LiHaoze-Bob/LingxiGlove/doc/灵犀手套_KickOff_会议.pptx

灵犀手套 LingxiGlove

双节点手语翻译系统 KickOff

2026 全国大学生物联网设计竞赛 · Espressif 赛道

Lingxi Team · 2026-05-23

## Slide 2

问题陈述

2,780 万

中国听障群体人数

5,500+

中文手语词汇量

<5%

手语翻译覆盖率估算

听障群体与健听人之间存在巨大的沟通鸿沟。现有商用手语翻译方案价格高昂（¥5,000 ~ ¥80,000），难以普及。需要一种低成本、高可用的实时手语→自然语音翻译方案。

目标：单手套 BOM ≈ ¥250，实现两个数量级降本，让手语翻译真正触手可及

## Slide 3

价值主张

社会价值

为 2780 万听障群体打通"手语→自然语音"的实时沟通通道。面向就医、求助、日常交流等高频场景，降低沟通门槛。

技术价值

ESP32-S3 + ESP-NOW 实现双手毫秒级时空同步。端侧规则识别→1D-CNN→云端 LLM 形成三级响应架构，渐进式 AI 升级。

成本优势

单手套 BOM ≈ ¥250，商用方案 ¥5k~¥80k。两个数量级降本，"极客普惠"叙事。契合 Espressif 赛道技术要求。

## Slide 4

系统五层架构

应用主控 · GestureApp / FingerSpelling / 采集模式 · LingxiGlove_Main.ino

L5

AI 与端云 · gesture_recognizer ← motion_detector · llm_client → tts_player → I2S · local_tts_fallback

L4

双手协同 · esp_now_sync (HandFrame 30B, MASTER ↔ SLAVE) · nvs_config (运行时角色/凭证)

L3

L2

传感器与执行器 · sensor_manager (MPU6050 + Flex ADC) · calibration · tts_player (I2S + MAX98357A)

L1

HAL · Arduino + FreeRTOS + ESP-IDF

Master (右手)

MPU6050 + Flex + MAX98357A

识别 / LLM / TTS / 播放

Slave (左手)

MPU6050

传感器帧上报

ESP-NOW

## Slide 5

硬件平台

Arduino Nano ESP32-S3 x2

8MB Flash + 512KB SRAM + OPI PSRAM。240MHz 双核，WiFi + BLE。

MPU6050 惯性传感器 x2

6 轴 IMU（加速度 + 陀螺仪）。I2C，50ms 采样。双手各 1 个。

弯曲传感器 x1（拇指）

单路模块，AO 接 ADC。区分握拳/张开两态。后续扩至 5 路。

MAX98357A I2S DAC

I2S 音频输出，BCLK/LRC/DIN 接 D4/D5/D6。驱动喇叭语音播报。

ESP-NOW 双板通信

链路层直连，HandFrame 30B 帧。毫秒级延迟，信道随 AP 同步。

NVS 运行时角色切换

单一固件，串口 role master/slave 切换。NVS 持久化，无需重编译。

约束：RST 不插扩展板（否则 USB 消失）；Flex 避开 A4/A5（I2C）；仅 2.4GHz WiFi

## Slide 6

软件流水线

sensor_manager

→

motion detector

→

calibration

→

gesture recognizer

→

arbitrator

→

llm client

→

tts player

→

I2S

15 个核心 C++ 模块

sensor_manager

http_client

llm_client

motion_detector

tts_player

calibration

local_tts_fallback

gesture_recognizer

offline_voice_pcm

gesture_arbitrator

accuracy_test

secrets

esp_now_sync

nvs_config

wifi_manager

15

核心 .cpp 模块

8

Host 单测套件

30B

HandFrame 协议帧

<10ms

每帧处理延迟

## Slide 7

关键技术创新

ESP-NOW 毫秒级硬同步

链路层协议绕过 WiFi 栈。HandFrame 30B 含 proto_version，信道随 AP 同步。解决双手时空对齐核心难题。

GestureArbitrator 统一决策

双手优先抑制单手（解决竞态），200ms 确认窗口 + 2s 冷却。模型无关，GestureCandidate 即接入。

Qwen-TTS + LittleFS 缓存

阿里 Qwen-TTS 非流式 WAV。FNV-1a 哈希缓存 LittleFS，命中零网络延迟。PSRAM + I2S DMA。

断网离线 PCM 兜底

local_tts_fallback 按 label 匹配离线 PCM。空表降级蜂鸣。"断网也能说救命"。

## Slide 8

AI 三级渐进架构

MVP-v1.1

端侧规则识别

RuleBased + BimanualRule

pitch/roll 阈值 + 500ms 防抖

Qwen-LLM 改写 + Qwen-TTS

V1.0

Edge Impulse 1D-CNN

双流模型（左右手各一流）

10 类 F1 >= 0.85

板上推理 < 50ms

V2.0

云端 Sign-Transformer

端侧分级触发

扩大词表至开放词汇

端云协同降级链路

当前

P3 进行中

P5-P6 规划中

核心设计：GestureRecognizer 抽象基类，MVP→ML 切换零改动主循环

## Slide 9

演示词汇清单（10 手势）

单手词汇（右手 Master）

你好

双手协同词汇（ESP-NOW）

加油

1

pitch up

6

双手同步上下

谢谢

2

pitch down

一起

7

双手同向推出

再见

3

roll 摆动

帮助

8

右手拳+左手托

明白了

我爱你

不

4

竖拇指

我们走

9

双手交叉胸口

5

握拳+拇指弯

10

代码待实现

全部词汇仅用 MPU6050 姿态角 + 拇指弯曲传感器，不依赖声学测距。任何人经短暂练习即可完成演示。

## Slide 10

当前进展

✓

P0 单手 MVP 完成

规则识别 + Qwen-TTS 闭环

✓

P1 ESP-NOW 双板通信

2026-05-14 完成，NVS 角色切换

✓

C 阶段风险全部缓解

motion_detector / calibration / local_tts_fallback

✓

手势仲裁层 (Solution C)

双手优先 + 确认窗口 + 冷却机制

8 个 Host 单测套件

全部通过，-Werror -Wpedantic

P2 弯曲传感器接入

拇指 1 路 Flex ADC，当前最高优先级

✓

!

15

核心模块

8

单测套件

10

演示手势

2

关键风险已缓解

## Slide 11

项目路线图

单手 MVP

P0

规则 + Qwen-TTS 闭环

已完成

Slave 固件 + ESP-NOW

P1

双板通信 + NVS 角色切换

已完成 05-14

弯曲传感器接入

P2

拇指 Flex ADC + 校准

进行中

Edge Impulse 1D-CNN

待开始

声学 TDOA 测距

P3

10 类 F1>=0.85

P4

Python 仿真完成

暂缓

云端 Sign-Transformer

P5

扩大词表

规划中

端云协同 + 降级联调

P6

断网播核心词

规划中

联调 + 答辩

P7

演示视频+现场对话

规划中

## Slide 12

风险分析与缓解

10 词表达力不足

中文手语 5500+ 词，10 手势覆盖有限

指拼模式兜底

动态手势分割 — 已缓解

连续手势粘连 — motion_detector 静止门控已实现

已缓解

跨用户识别率漂移

不同用户手势差异大

calibration 校准

断网哑火 — 已缓解

云端不可达 — local_tts_fallback + offline_voice_pcm

已缓解

弯曲传感器仅单路

只能区分握拳/张开两态

后续扩至 5 路

ESP-NOW 信道漂移

双手丢帧风险

强制同 AP 同步

## Slide 13

测试策略

现场准确率统计 (accuracy_test)

Host Unit Tests: C++11, make 即跑, -Werror -Wpedantic, 8 个套件

HOST 单测套件（全部通过）

Hardware-in-the-Loop: test_speaker / test_acoustic_tdoa

test_motion_detector (16)

test_calibration_core (24)

test_local_tts_fallback (20)

test_esp_now_sync (24)

test_bimanual_recognizer (8)

test_arbitrator (24)

test_llm_rewrite

accuracy_test 现场评测

混淆矩阵 + LittleFS CSV 日志。test 命令族支持按手势 ID 批量测试、导出、清除。

test_tts_parsers

CI 友好

纯 C++11，无 Arduino 依赖。每个测试目录自带 mock，make 直接编译运行。

## Slide 14

下一步计划

1

P2 弯曲传感器接入

拇指 1 路 Flex ADC 接线 + 校准 + 手势规则更新。验证 ADC 差值 > 200 count。

当前最高优先级

P3 双手数据采集 + Edge Impulse 1D-CNN

每词汇 50+ 组样本，训练轻量 1D-CNN 模型，导出 Arduino 库替换 RuleBasedRecognizer。

2

P2 完成后启动

竞赛答辩准备

录制演示视频、完善 PPT、现场对话演示。确保"我们走"代码实现 + 离线 PCM 填充。

3

P3 完成后启动

## Slide 15

Q & A

Thank You

灵犀手套 — 让手语被听见

Lingxi Team · 2026-05-23
