LiHaoze-Bob/LingxiGlove/doc/images/图1_系统五层架构图_v2.png

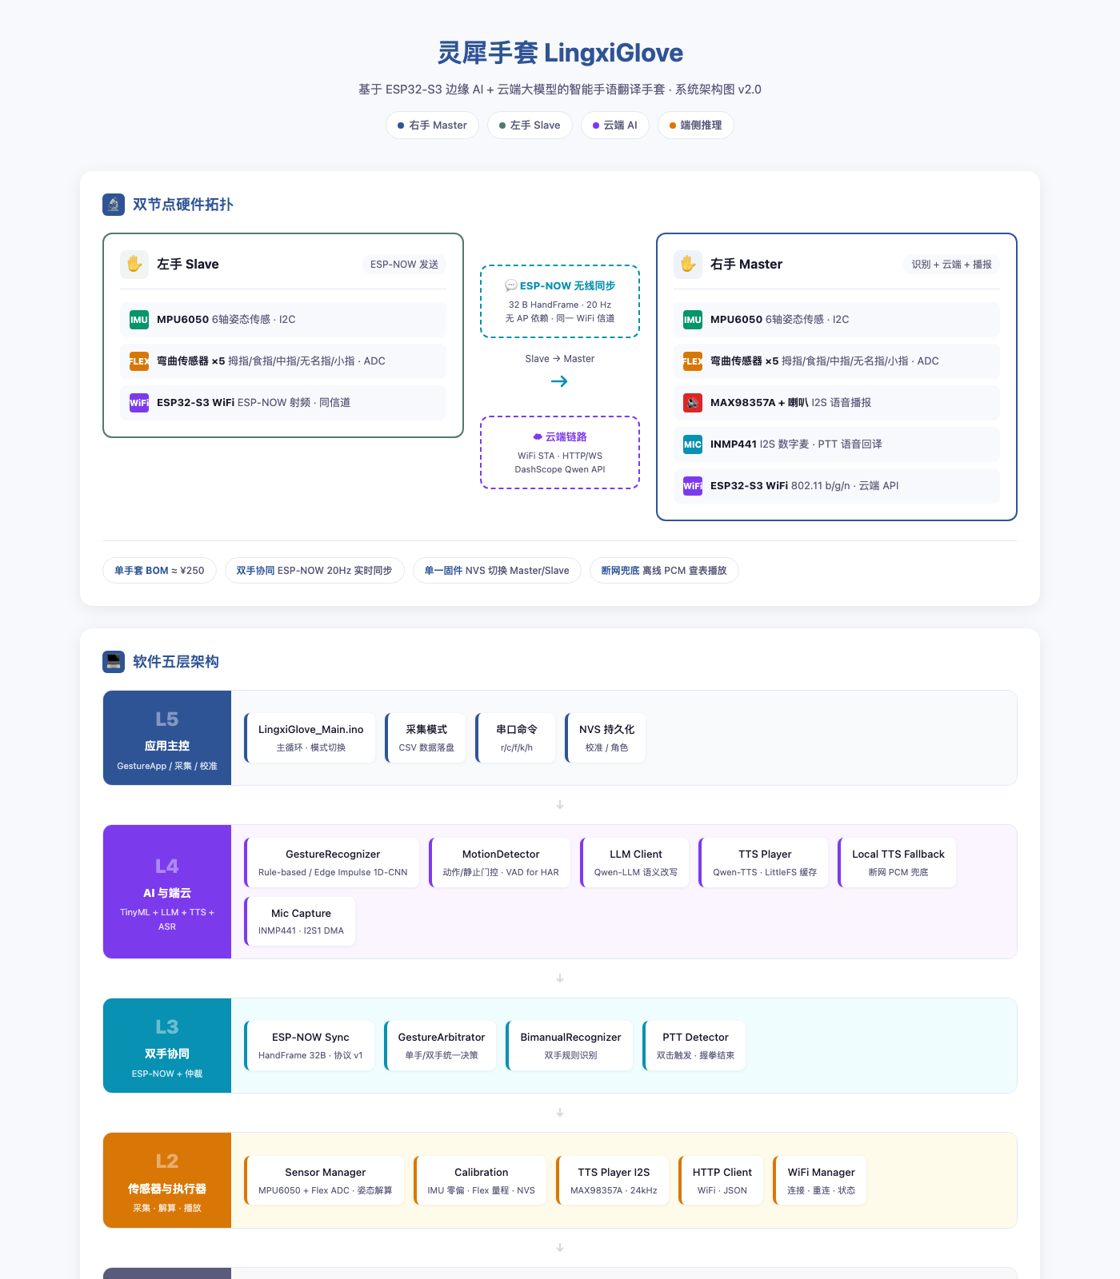
doc/images/图1_系统五层架构图_v2.png
