LiHaoze-Bob/LingxiGlove/doc/images/图2_双向交流数据流图_v2.png

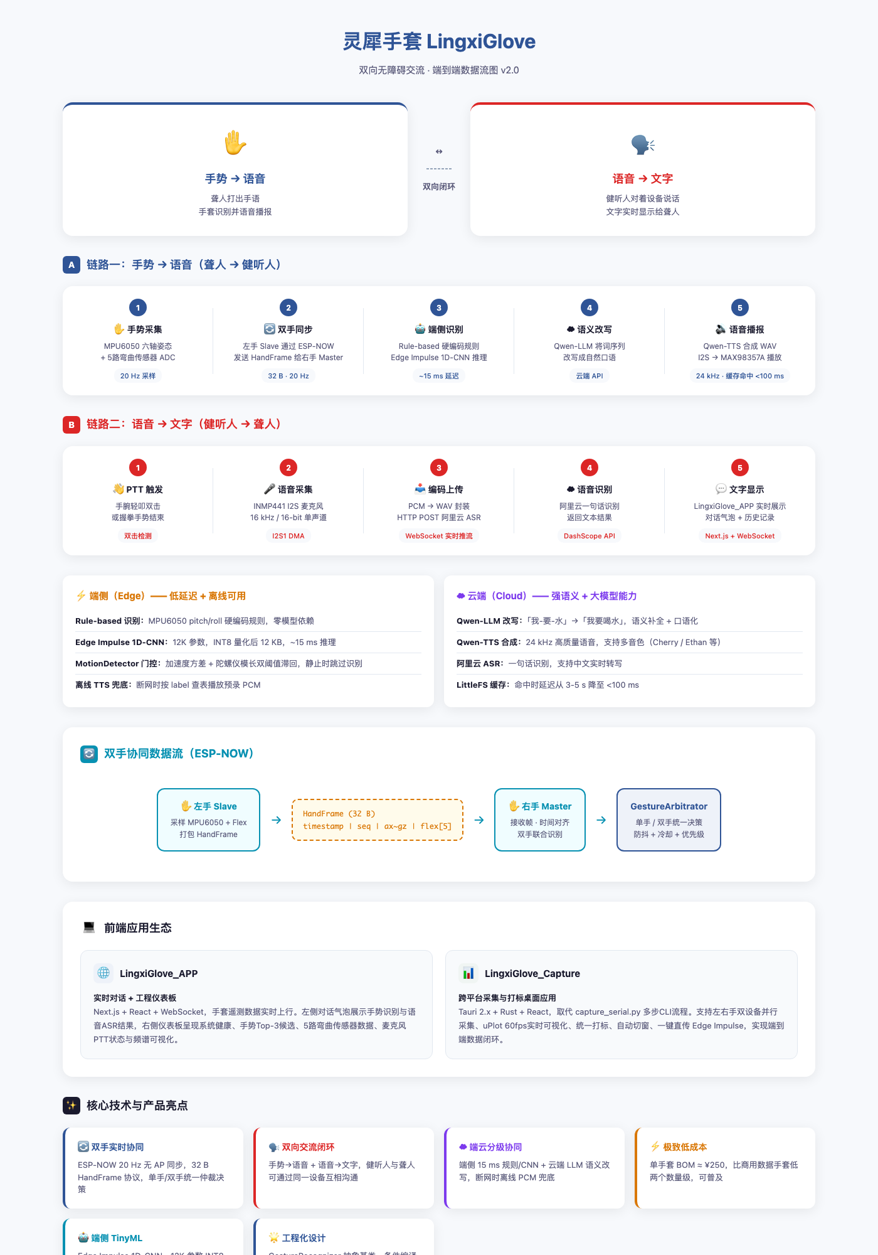
doc/images/图2_双向交流数据流图_v2.png
