LiHaoze-Bob/LingxiGlove/doc/images/图2_软件任务调度与数据流图.png

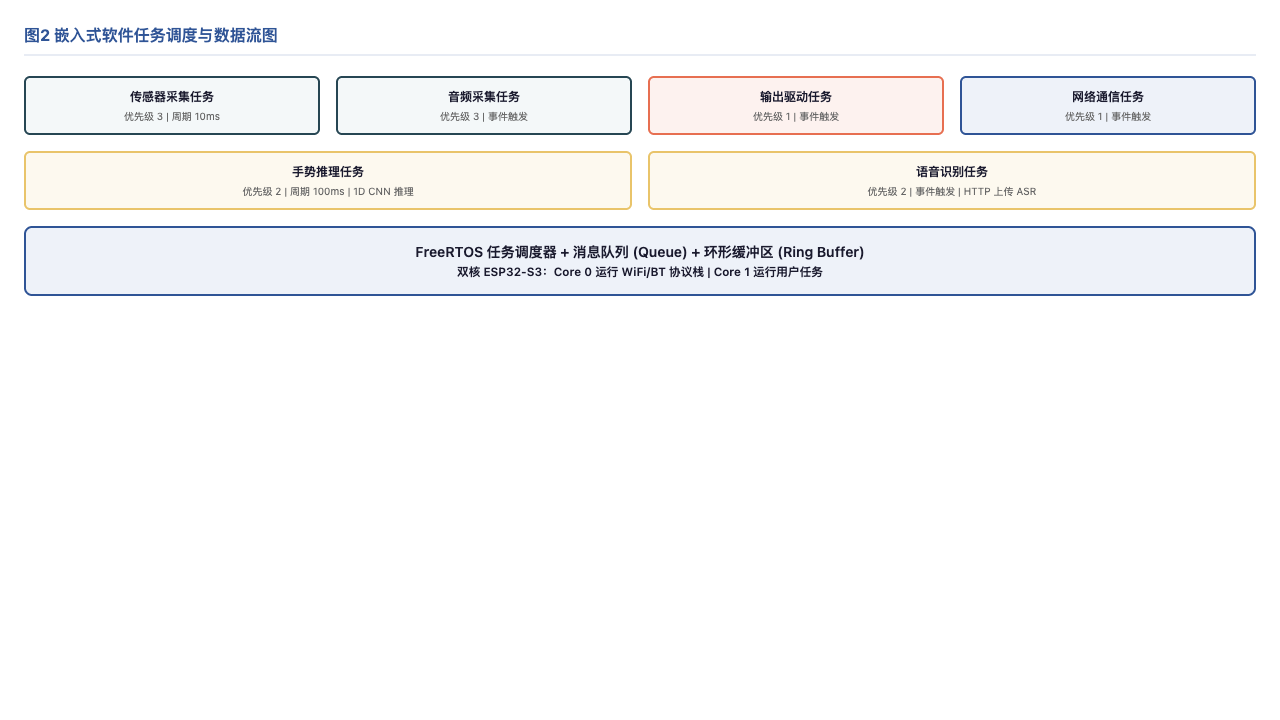
doc/images/图2_软件任务调度与数据流图.png
