LiHaoze-Bob/LingxiGlove/doc/images/图3_1D_CNN模型架构图.png

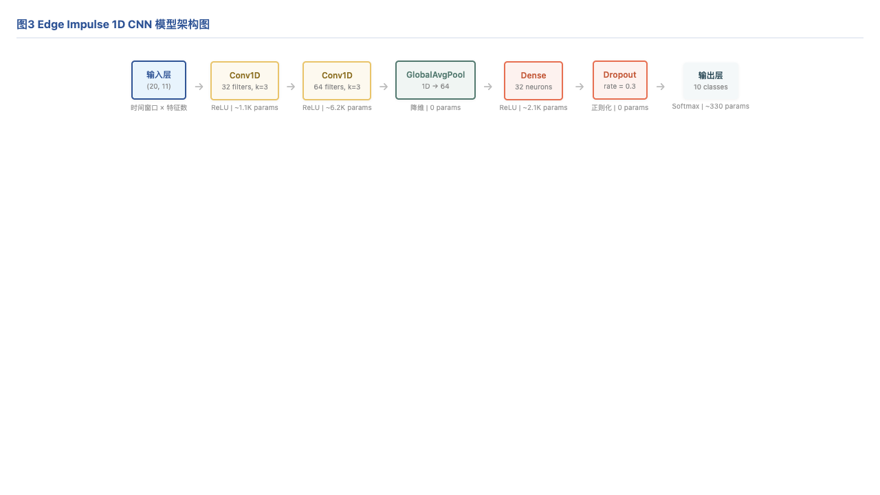
doc/images/图3_1D_CNN模型架构图.png
