LiHaoze-Bob/LingxiGlove/doc/灵犀手套Lingxi_项目执行计划.xlsx

Sheet: 任务清单
ID | 阶段 | 任务名称 | 详细描述 | 负责模块 | 状态 | 完成日期 | 依赖 | 验收标准
P0.1 | P0 单手MVP | 单手 MVP 规则识别 | pitch/roll 阈值判定 + 500ms 防抖 + 2s 冷却 | gesture_recognizer | ✅完成 | 2026-05-01 | - | pitch/roll 阈值 + 500ms 防抖闭环
P0.2 | P0 单手MVP | Qwen-TTS 语音合成 | 非流式 WAV 合成 + LittleFS FNV-1a 缓存 + I2S DMA 播放 | tts_player | ✅完成 | 2026-05-09 | P0.1 | 非流式 WAV + LittleFS 缓存 + I2S 播放
P0.3 | P0 单手MVP | LLM 改写接入 | Qwen/百度双 provider + SSE 流式 + token 过期回退 | llm_client | ✅完成 | 2026-05-05 | P0.1 | Qwen/百度双 provider + token 回退
P0.4 | P0 单手MVP | DRAM 溢出修复 | s_pcm_accum_buf[192000] 迁移 PSRAM (EXT_RAM_ATTR) | tts_player / http_client | ✅完成 | 2026-05-05 | - | PSRAM 迁移 192KB，dram0 不再溢出
P0.5 | P0 单手MVP | WiFi 连接管理 | STA 模式连接 + 断线 30s 内自动重连守护任务 | wifi_manager | ✅完成 | 2026-05-01 | - | 断线 30s 内重连
P1.1 | P1 ESP-NOW | Slave 固件 + MPU6050 | 第二块 ESP32-S3 烧录 + I2C 传感器验证 | esp_now_sync / sensor_manager | ✅完成 | 2026-05-11 | P0 | I2C 读数正常
P1.2 | P1 ESP-NOW | ESP-NOW 双板通信 | HandFrame 30B 帧结构 + MASTER/SLAVE 配对 + LED 蓝灯 | esp_now_sync | ✅完成 | 2026-05-14 | P1.1 | "Slave 已连接" + 双板 LED 蓝
P1.3 | P1 ESP-NOW | NVS 运行时角色配置 | 串口 role master/slave + NVS 持久化 + 重启生效 | nvs_config | ✅完成 | 2026-05-11 | P1.1 | role master/slave 串口切换
P1.4 | P1 ESP-NOW | 信道同步修复 | Slave 连同一 AP 同步 WiFi 信道，解决帧全部丢失 | esp_now_sync / wifi_manager | ✅完成 | 2026-05-14 | P1.2 | Slave 连同一 AP，帧丢失率 ≈ 0
C.1 | C 风险缓解 | 动作/静止门控 | 加速度方差 + 陀螺仪模长双阈值迟滞状态机 | motion_detector | ✅完成 | 2026-05-16 | P0 | 双阈值迟滞状态机
C.2 | C 风险缓解 | 个体校准 | IMU 零偏 + Flex 量程校准，NVS 持久化，启动自动加载 | calibration | ✅完成 | 2026-05-16 | P0 | NVS 持久化零偏 + 量程
C.3 | C 风险缓解 | 离线 TTS 兜底 | 按 label 匹配离线 PCM 表 + 空表降级蜂鸣 | local_tts_fallback / offline_voice_pcm | ✅完成 | 2026-05-16 | P0.2 | label 命中 PCM + 空表蜂鸣
P2.1 | P2 弯曲传感器 | 弯曲传感器接线 | 拇指 1 路 Flex ADC (A0)，确认安装方向 | sensor_manager | 🔥进行中 | - | C.2 | ADC 差值 > 200 count
P2.2 | P2 弯曲传感器 | Flex 校准 | 记录伸直/弯曲 ADC 读数，填入 FLEX_ADC_MIN/MAX | calibration | ⏳待开始 | - | P2.1 | FLEX_ADC_MIN/MAX 实测
P2.3 | P2 弯曲传感器 | 手势规则更新 | 叠加拇指弯曲条件区分握拳类与张开类手势 | gesture_recognizer | ⏳待开始 | - | P2.2 | 握拳/张开两态区分
D.1 | 双手识别+仲裁 | 双手识别器 | BimanualRuleRecognizer + "帮助" 规则（左手托举+右手居中） | gesture_recognizer | ✅完成 | 2026-05-20 | P1.2 | BimanualRule + 帮助规则
D.2 | 双手识别+仲裁 | 手势仲裁层 | 方案 C 统一决策层：双手优先 + 200ms 确认 + 2s 冷却 | gesture_arbitrator | ✅完成 | 2026-05-22 | D.1 | 双手优先 + 200ms 确认 + 2s 冷却
D.3 | 双手识别+仲裁 | 准确率测试模块 | 混淆矩阵 + LittleFS CSV + test 串口命令族 | accuracy_test | ✅完成 | 2026-05-20 | P0 | LittleFS CSV + test 命令族
P3.1 | P3 Edge Impulse | Edge Impulse 项目创建 | 双手项目，输入维度 ax/ay/az/gx/gy/gz + flex×N | - | ⏳规划中 | - | P2.3 | 双手项目 + 输入维度配置
P3.2 | P3 Edge Impulse | 手势数据采集 | 10 个词汇各 50+ 组样本（不同速度/角度） | - | ⏳规划中 | - | P3.1 | 每词汇 50+ 组样本
P3.3 | P3 Edge Impulse | 1D-CNN 模型训练 | 1D-CNN 或 Flatten+Dense 轻量模型，板上推理 < 50ms | - | ⏳规划中 | - | P3.2 | 10 类 F1 >= 0.85，推理 < 50ms
P3.4 | P3 Edge Impulse | EdgeImpulseRecognizer 接入 | 导出 Arduino 库，实现抽象基类替换 | gesture_recognizer | ⏳规划中 | - | P3.3 | 替换 RuleBased 零改动主循环
P4.1 | P4 声学TDOA | INMP441 采购 | MEMS 麦克风模块采购（P4 阶段视竞赛需求） | - | ⏸暂缓 | - | - | 麦克风到货
P4.2 | P4 声学TDOA | TDOA 真机 POC | 17-19kHz chirp + 匹配滤波，Arduino POC | test_acoustic_tdoa | ⏸暂缓 | - | P4.1 | 50cm 量程 < 5cm 误差
P5.1 | P5 云端 | Sign-Transformer 立项 | 词表规模、Top-k、模型架构确定 | - | ⏳规划中 | - | P3.4 | 词表 / Top-k 确定
P6.1 | P6 端云联调 | 端云分级 + 降级联调 | 端侧置信度阈值触发云端 + 断网回落端侧 top-1 | llm_client / tts_player | ⏳规划中 | - | P5.1 | 断网播核心词
P7.1 | P7 答辩 | 演示视频录制 | 完整演示流程录制（单手+双手词汇） | - | ⏳规划中 | - | P6.1 | 完整演示流程
P7.2 | P7 答辩 | 答辩材料准备 | PPT 完善 + 现场对话演练 | - | ⏳规划中 | - | P6.1 | PPT + 现场对话
P7.3 | P7 答辩 | "我们走" 代码实现 | 双手 #5 规则 + accuracy_test ID=105 | gesture_recognizer / accuracy_test | ⏳规划中 | - | P2.3 | accuracy_test 有 ID=105
T.1 | 测试 | Host 单测 8 套件 | C++11 纯主机测试，-Werror -Wpedantic | tests/ | ✅完成 | 2026-05-22 | - | -Werror -Wpedantic 全通过
T.2 | 测试 | 离线 PCM 表填充 | 运行 gen_offline_voice_pcm.py 生成 10 条离线音频 | tools/gen_offline_voice_pcm.py | ⏳待开始 | - | P0.2 | 10 条 PCM ≈ 320KB

Sheet: 甘特图
ID | 任务名称 | 状态 | W1 4/21 | W2 4/28 | W3 5/5 | W4 5/12 | W5 5/19 | W6 5/26 | W7 6/2 | W8 6/9 | W9 6/16 | W10 6/23 | W11 6/30 | W12 7/7 | W13 7/14 | W14 7/21 | W15 7/28 | W16 8/4 | W17 8/11 | W18 8/18
P0.1 | 单手 MVP 规则识别 | ✅完成
P0.2 | Qwen-TTS 语音合成 | ✅完成
P0.3 | LLM 改写接入 | ✅完成
P0.4 | DRAM 溢出修复 | ✅完成
P0.5 | WiFi 连接管理 | ✅完成
P1.1 | Slave 固件 + MPU6050 | ✅完成
P1.2 | ESP-NOW 双板通信 | ✅完成
P1.3 | NVS 运行时角色配置 | ✅完成
P1.4 | 信道同步修复 | ✅完成
C.1 | 动作/静止门控 | ✅完成
C.2 | 个体校准 | ✅完成
C.3 | 离线 TTS 兜底 | ✅完成
P2.1 | 弯曲传感器接线 | 🔥进行中
P2.2 | Flex 校准 | ⏳待开始
P2.3 | 手势规则更新 | ⏳待开始
D.1 | 双手识别器 | ✅完成
D.2 | 手势仲裁层 | ✅完成
D.3 | 准确率测试模块 | ✅完成
P3.1 | Edge Impulse 项目创建 | ⏳规划中
P3.2 | 手势数据采集 | ⏳规划中
P3.3 | 1D-CNN 模型训练 | ⏳规划中
P3.4 | EdgeImpulseRecognizer 接入 | ⏳规划中
P4.1 | INMP441 采购 | ⏸暂缓
P4.2 | TDOA 真机 POC | ⏸暂缓
P5.1 | Sign-Transformer 立项 | ⏳规划中
P6.1 | 端云分级 + 降级联调 | ⏳规划中
P7.1 | 演示视频录制 | ⏳规划中
P7.2 | 答辩材料准备 | ⏳规划中
P7.3 | "我们走" 代码实现 | ⏳规划中
T.1 | Host 单测 8 套件 | ✅完成
T.2 | 离线 PCM 表填充 | ⏳待开始
图例: |  | 已完成 |  | 进行中 |  | 规划中 |  | 暂缓

Sheet: 里程碑
里程碑 | 验收标准 | 状态 | 完成日期 | 备注
M1: Slave 固件运行 + ESP-NOW 双板通信 | Master 串口打印 "Slave 已连接"，双板 LED 亮蓝色 | ✅完成 | 2026-05-14 | P1 完成
M2: 弯曲传感器接入 + 校准完成 | 采集模式 CSV 弯曲列稳定，握拳/展开 ADC 差值 > 200 count | 🔥进行中 | - | P2
M3: 全词汇演示可跑通（规则识别器） | 10 个演示词汇均可触发 TTS 播报，误识率 < 20% | ⏳待开始 | - | P2 + P3 后
M4: Edge Impulse 模型上板推理 | 10 个词汇识别准确率 > 90%，推理延迟 < 50ms | ⏳待开始 | - | P3
M5: 竞赛答辩 | 演示视频 + 现场对话演示 | ⏳待开始 | - | P7
