LiHaoze-Bob/LingxiGlove/doc/acoustic_tdoa_simulation_results.md

# 声学 TDOA 测距仿真结果 (由 tools/acoustic_tdoa_simulate.py 生成)

## 仿真参数

- 采样率 fs = 48000 Hz
- 声速 c = 343.0 m/s
- chirp: 17000–19000 Hz, 时长 5.0 ms
- rx 总长 = 30.0 ms
- Monte Carlo 次数 = 500 / 格子
- 随机数种子 = 0
- 单样本距离步长 c/fs ≈ **7.146 mm**
  （即本脚本的精度下限；匹配滤波仅取整数 argmax，不做亚样本插值）

## 关键设计：为什么不用亚样本插值

早期版本尝试过『频域分数延迟 + 三点抛物线亚样本插值』的组合，希望把精度
从 7.15mm 降到亚毫米级。经过 5 轮对照诊断（见代码注释），发现：
- 抛物线插值对 **δ 冲激输入** 只有 ~0.1 样本残差（符合理论）
- 但对 **chirp 匹配滤波的输出**，由于 chirp 自相关主瓣非对称（线性调频带来
  相位-时间耦合），抛物线拟合会产生 **~1 样本的算法本质偏置**，比理论
  预期的 1/10 样本精度差一个数量级
- 即使用 16× 过采样生成的『真·延迟 0.25 样本 chirp』作为 ground truth，
  原采样率下抛物线估计的偏置仍高达 +0.508 样本

因此本脚本放弃亚样本插值，所有数字都是『整数样本 argmax』的真实结果。这也
意味着精度下限保守地停在 c/fs ≈ 7.15mm，要突破需改用 sinc 插值、复相关相位法或更高采样率，留给后续 D3（真机 POC）专题验证。

## 结果解读

RMSE 的两个贡献源：
1. **量化偏置**（deterministic）：`round(D*fs/c)/fs*c - D`；
   即便 SNR → ∞ 也消不掉，只能靠更高采样率降低。
2. **噪声方差**（stochastic）：SNR 越低越大，体现为 std 上升；
   SNR 足够低时匹配滤波整个峰被噪声淹没，RMSE 会跳变到『随机猜』级别。

下方两张表：
- **Noise-Free Bias 表**：`round(D*fs/c)/fs*c - D`；RMSE 的绝对下限。
- **RMSE 矩阵**：Monte Carlo 带噪结果。高 SNR 行数值应趋近 |Noise-Free Bias|，
  低 SNR 行由噪声主导。当 RMSE 超过 chirp 时长对应的距离（约 1.7m）时，
  说明匹配滤波峰已失效，此 SNR 下物理上不可用（表后会标 ⚠️）。

各距离对应的理论延迟样本数：

  - D=0.10 m → 理论延迟 13.994 样本；若不做亚样本插值，整数量化引入偏置 +0.042 mm
  - D=0.30 m → 理论延迟 41.983 样本；若不做亚样本插值，整数量化引入偏置 +0.125 mm
  - D=0.50 m → 理论延迟 69.971 样本；若不做亚样本插值，整数量化引入偏置 +0.208 mm
  - D=0.80 m → 理论延迟 111.953 样本；若不做亚样本插值，整数量化引入偏置 +0.333 mm
  - D=1.00 m → 理论延迟 139.942 样本；若不做亚样本插值，整数量化引入偏置 +0.417 mm
  - D=1.50 m → 理论延迟 209.913 样本；若不做亚样本插值，整数量化引入偏置 +0.625 mm

## Noise-Free Bias（无噪单次仿真的 `D_hat - D`；单位：mm）

| D (m) | Noise-Free Bias (mm) |
|---|---|
| 0.10 | +0.042 |
| 0.30 | +0.125 |
| 0.50 | +0.208 |
| 0.80 | +0.333 |
| 1.00 | +0.417 |
| 1.50 | +0.625 |

## RMSE 矩阵（行 = 真实距离 D，列 = SNR dB；单位：mm）

| D (m) | SNR=-10dB | SNR=0dB | SNR=10dB | SNR=20dB | SNR=30dB |
|---|---|---|---|---|---|
| 0.10 | 904.846 | 13.708 | 0.042 | 0.042 | 0.042 |
| 0.30 | 813.987 | 13.225 | 0.125 | 0.125 | 0.125 |
| 0.50 | 796.746 | 12.598 | 0.208 | 0.208 | 0.208 |
| 0.80 | 680.530 | 13.840 | 0.333 | 0.333 | 0.333 |
| 1.00 | 740.370 | 13.132 | 0.417 | 0.417 | 0.417 |
| 1.50 | 735.981 | 13.766 | 0.625 | 0.625 | 0.625 |
