LiHaoze-Bob/LingxiGlove/src/tests/test_acoustic_tdoa/chirp_pcm.h

// chirp_pcm.h — 由 tools/gen_chirp_pcm.py 自动生成，请勿手工编辑
//
// D2 声学 TDOA POC 所用的线性 chirp 模板（int16，单声道 PCM）。
// 参数: fs=48000 Hz, dur=5.0 ms (240 samples),
//       f0=17000 Hz → f1=19000 Hz, Hann window,
//       normalized peak = 28000 (leaves ~14.5% headroom)
//
// 必须与 tools/acoustic_tdoa_simulate.py 的参数完全一致，才能把
// D3 真机实测数据直接对照 D1 的仿真 RMSE 表格。

#ifndef CHIRP_PCM_H_
#define CHIRP_PCM_H_

#include <stdint.h>
#include <pgmspace.h>  // PROGMEM (Arduino/ESP32)

// 用 constexpr 保证 kChirpLen 可以作为 C++11 数组长度的整型常量表达式。
// 非 constexpr 的 static const 在部分严格编译器 (如 -pedantic) 下用作数组长度
// 会告警；POC 直接统一成 constexpr 最稳妥。
constexpr uint32_t kChirpSampleRate = 48000u;
constexpr uint32_t kChirpLen        = 240u;
constexpr float    kChirpF0Hz       = 17000.0f;
constexpr float    kChirpF1Hz       = 19000.0f;
constexpr float    kChirpDurMs      = 5.000f;

static const int16_t kChirpPcm[kChirpLen] PROGMEM = {
         0,     -3,     -5,     40,    -67,     17,    121,   -235,    164,    133,   -457,    484,
       -54,   -595,    927,   -530,   -457,   1319,  -1263,    113,   1395,  -2057,   1143,    889,
     -2565,   2448,   -336,  -2380,   3609,  -2156,  -1200,   4064,  -4124,    989,   3284,  -5522,
      3778,   1033,  -5558,   6334,  -2413,  -3686,   7585,  -6181,     73,   6595,  -8944,   4915,
      3012,  -9329,   9326,  -2576,  -6487,  11484,  -8576,   -635,   9950, -12756,   6706,   4406,
    -13024,  12977,  -3870,  -8383,  15416, -12121,    320,  12227, -16941,  10283,   3649, -15659,
     17536,  -7650,  -7743,  18489, -17240,   4456,  11705, -20615,  16174,   -946, -15338,  22026,
    -14510,  -2648,  18514, -22779,  12441,   6133, -21171,  22977, -10163,  -9358,  23301, -22755,
      7856,  12218, -24938,  22257,  -5673, -14648,  26141, -21621,   3739,  16615, -26983,  20969,
     -2148, -18108,  27535, -20405,    968,  19130, -27859,  20005,   -244, -19688,  28000, -19817,
         0,  19788, -27981,  19862,   -244, -19433,  27802, -20132,    965,  18619, -27440,  20592,
     -2139, -17342,  26851, -21178,   3718,  15597, -25976,  21801,  -5633, -13389,  24743, -22348,
      7789,  10742, -23084,  22688, -10061,  -7704,  20941, -22680,  12295,   4361, -18283,  22188,
    -14316,   -842,  15119, -21094,  15930,  -2683, -11517,  19318, -16947,   6001,   7604, -16840,
     17202,  -8875,  -3576,  13720, -16582,  11069,   -313, -10104,  15053, -12374,   3774,   6228,
    -12684,  12655,  -6521,  -2403,   9662, -11880,   8314,  -1028,  -6279,  10154,  -9009,   3735,
      2904,  -7716,   8605,  -5467,     70,   4923,  -7263,   6113,  -2305,  -2195,   5293,  -5735,
      3586,    -71,  -3106,   4576,  -3884,   1584,   1125,  -3014,   3367,  -2236,    311,   1467,
     -2362,   2127,  -1044,   -287,   1262,  -1536,   1129,   -347,   -403,    816,   -800,    469,
       -46,   -267,    371,   -290,    125,     18,    -84,     77,    -38,      7,      1,      0
};

#endif  // CHIRP_PCM_H_
