LiHaoze-Bob/LingxiGlove/(commit log)

2026-05-01 chore: initial public repo for LingxiGlove (MVP with TTS loop working)
    [acoustic_tdoa_simulation_results.csv]
2026-05-01 perf(config): upgrade TTS model to qwen3-tts-flash for 30% faster synthesis
    Why:
    qwen-tts (standard) takes 500~1500ms to synthesize a short Chinese sentence.
    Switching to qwen3-tts-flash reduces cloud synthesis time by ~30% according
    to DashScope official benchmarks, with no perceptible quality difference for
    short oral sentences in MVP scenarios.
    What:
    - QWEN_TTS_MODEL: "qwen-tts" -> "qwen3-tts-flash"
    - REST endpoint, request/response schema and auth unchanged; zero code change
    - Added ENABLE_LLM_REWRITE, LLM_REWRITE_MAX_BYTES, LLM_REWRITE_PROMPT_TEMPLATE
    macros (from L2 LLM rewrite feature, bundled in same config block)
    Impact:
    - Flash / SRAM: no change
    - TTS synthe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
    [config.h]
2026-05-01 perf(llm): switch chatQwen to SSE streaming to reduce rewrite latency
    Non-streaming POST waits for the server to finish generating all tokens before
    sending the response body (~1500~3000ms total). SSE streaming lets the client
    read deltas as they arrive and stop as soon as finish_reason=stop is received,
    cutting the wait to ~500~2000ms (saves 800~1500ms in typical cases).
    - chatQwen now calls httpPostJsonSse with incremental_output=true
    - Lambda onLine accumulates content deltas from
    output.choices[0].message.content per SSE frame
    - Stops reading on finish_reason=stop OR data:[DONE], whichever comes first
    - Added system prompt to guide model toward short answe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
    [llm_client.cpp, llm_client.h]
2026-05-01 feat(main): wire LLM rewrite layer and add 'l' serial command for rewrite+TTS test
    After landing chatQwen SSE (P1) and rewriteGestureToSentence, the main loop
    needed to call rewrite before speak() so users hear natural sentences instead
    of raw gesture labels. A serial command is needed to test the rewrite+TTS
    pipeline without relying on the gesture recognition flow.
    - doRecognizeStep: before speak(result.text), call rewriteGestureToSentence
    guarded by ENABLE_LLM_REWRITE and WiFi.status()==WL_CONNECTED;
    fallback to original result.text on empty return (never blocks playback)
    - Offline PCM fallback still uses result.text (raw label) since the offline
    table i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
2026-05-01 test(test-tts): add host-side unit tests for TrimRewriteNoise (15 cases)
    TrimRewriteNoise is a pure string function that strips LLM-added wrapper noise
    (quotes, brackets, newlines) from rewrite results. It runs on-device but can be
    fully exercised on the host with an Arduino String shim, giving fast feedback
    without hardware flashing.
    - 15 test cases covering: clean input, leading/trailing spaces, CRLF, ASCII
    double/single/backtick quotes, Chinese full-width quotes, Japanese bracket
    quotes, nested wrapping, inner quotes preserved, empty string,
    whitespace-only, asymmetric quote (no-strip), mixed noise
    - Arduino String shim re-implements length/trim/startsW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
2026-05-01 docs: add PERFORMANCE_OPTIMIZATION.md covering P0/P1 and future roadmap
    Performance decisions (model choice, streaming vs batch, WebSocket evaluation)
    need to be documented so future contributors understand the rationale and can
    continue the optimization roadmap without re-deriving the analysis.
    - End-to-end latency breakdown (A~F stages) before and after optimization
    - P0: qwen-tts->qwen3-tts-flash rationale and measured impact
    - P1: SSE streaming design, DashScope frame format, memory impact table
    - Evaluated-but-deferred: WebSocket Realtime TTS (P2) and full LLM+TTS
    pipeline (P3) with explicit rejection reasons for current stage
    - Historical stability fixes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
2026-05-01 perf(tts): add software volume gain (2x default) with saturating clamp
    MAX98357A GAIN pin is floating by default (9dB hardware gain). Without
    changing hardware wiring, audio output is noticeably quiet in ambient
    environments. A software gain multiplier applied before i2s_write lets
    users tune volume without any hardware modification.
    - config.h: new TTS_VOLUME_GAIN macro (default 2.0f = +6dB, range 1.0~4.0)
    with comment explaining hardware GAIN pin alternatives (float gain=1.0
    disables processing; floating GAIN=9dB, 100K-to-GND=15dB, direct-GND=12dB)
    - tts_player.cpp: new ApplyGain(buf, byte_count) helper
    * reinterprets uint8 buffer as int16 samples, multi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
2026-05-01 fix(llm): match "data:" prefix without space to fix SSE content never received
    Root cause (confirmed via curl + xxd):
    DashScope SSE actually sends "data:{...}" (no space after colon),
    but the on_line callback was checking line.startsWith("data: ") (with space).
    Every single data frame was treated as a non-data line and skipped,
    so `accumulated` was always empty, resulting in:
    [LLM-SSE] 未收到有效内容
    [LLM] 模型回复: [错误] 通义千问响应为空
    [LLM改写] 失败，回落原词
    Fix:
    - startsWith("data: ") -> startsWith("data:") [remove the space]
    - json_str = line.c_str() + 6 -> + 5 (skip 5-byte "data:" prefix)
    - Added `while (*json_str == ' ') ++js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
    [llm_client.cpp]
2026-05-01 fix(tts): handle streaming WAV from Qwen-TTS (data chunk size = ~INT32_MAX)
    Root cause:
    Qwen-TTS returns a streaming WAV file where the "data" chunk size field is
    filled with a placeholder value (~0x7FFFFFFB ≈ 2 GB) because the server
    does not know the total length at encoding time. The download loop used
    `remaining = wav_data_bytes` as the exit condition, so:
    1. remaining was always > 0 (2 GB never reached zero)
    2. The 15s kOverallTimeoutMs safety guard fired prematurely
    3. total_written * 2 < wav_data_bytes => speak() returned false
    Result: "[TTS] 警告: 音频总时长超限" after only ~20 KB written,
    audio cut off after ~0.4 s instead of playing the fu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
    [tts_player.cpp]
2026-05-01 perf(tts): replace two-step HTTP with SSE streaming to eliminate playback latency
    Root cause: the old flow made two TLS round trips (POST→audio.url, then GET .wav),
    waited for the full TTS segment to be synthesized server-side before returning the
    URL, and wrote i2s_write(portMAX_DELAY) inside the SSE callback which stalled TCP
    reads, causing a 12× latency regression (0.76s audio took 9s in practice).
    New flow:
    - Single POST with X-DashScope-SSE: enable header; server pushes base64 PCM frames
    incrementally
    - SSE callback only does base64 decode + memcpy into static s_pcm_accum_buf[60000],
    no i2s_write during TCP receive
    - After SSE stream ends, write accumulated PCM to I2S in 4096-by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
    [tts_player.cpp, tts_player.h]
2026-05-01 perf(http): replace byte-by-byte SSE read with batch readBytes to fix 9x slowdown
    Root cause: the old SSE read loop called stream->read() one byte at a time with
    delay(2) on each empty poll. At ~8000 bytes per base64 frame this meant 8000
    iterations with potential dead delay per frame, making actual throughput 10x
    slower than the WiFi link capacity (measured: 0.76s audio took 9s to play).
    - Read all available bytes in one readBytes() call into static s_batch_buf[2048]
    - Scan for newline boundaries with memchr() instead of character-by-character loop
    - Expanded s_line_buf from 512 B to 8192 B to fit full base64 frames without truncation
    - Reduced idle poll delay from delay(2) to delay(1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
    [http_client.cpp]
2026-05-01 feat(config): unify debug logging macro and set 24 kHz as default I2S rate
    Introduced DEBUG_LOG(fmt, ...) macro that prepends a millisecond timestamp and
    formats via snprintf into a stack buffer before writing atomically with
    Serial.write(). This avoids ets_printf UTF-8 truncation and Serial.print +
    Serial.println interleaving that caused garbled multi-segment log lines.
    DEBUG_PRINTLN(msg) is now a thin wrapper over DEBUG_LOG to maintain call-site
    compatibility. DEBUG_PRINT retained for CSV data stream output only.
    TTS_I2S_DEFAULT_SAMPLE_RATE changed from 16000 to 24000 to match Qwen-TTS PCM
    output, removing the need for i2s_set_sample_rates() calls around every TTS
    playback and eliminatin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
    [config.h]
2026-05-01 fix(main): add startup TTS retry after WiFi connect to handle cold TLS failure
    Reproduction: on cold boot, speak() is called immediately after WiFi connects.
    The TLS session cache is empty at this point and the first HTTPS handshake to
    dashscope.aliyuncs.com occasionally fails with 'connection refused' (observed
    in logs: 7s wait then error at every cold boot).
    Fix: check return value of speak() at startup; if it fails wait 2s for the TLS
    stack to warm up then retry once.
    Also migrated all Serial.print/println calls in LingxiGlove_Main.ino to
    DEBUG_LOG/DEBUG_PRINTLN macros for consistent timestamped log output.
    [LingxiGlove_Main.ino]
2026-05-01 refactor(sensor,wifi,calib,tts-offline,llm): migrate Serial.print to DEBUG_LOG macros
    Mechanical migration of all Serial.print(x); Serial.println(y) multi-segment
    log patterns to the new DEBUG_LOG(fmt, ...) / DEBUG_PRINTLN(msg) macros
    introduced in config.h. No behavioral change; improves log readability
    by adding millisecond timestamps and ensuring atomicity of multi-argument
    log lines that were previously interleaved in output.
2026-05-01 docs(acoustic): add §4.8 RTT-TOF principle and §4.9 engineering risk assessment
    §4.8 双向 RTT-TOF 技术原理详解:
    - §4.8.1 单向 TOF 不够的根因：跨板时钟绝对偏差 δ 不因短期漂移决定，
    而由两板上电零点差异决定（60s 运行最坏 1.2ms = 412mm 距离误差）
    - §4.8.2 RTT-TOF 数学推导：差分公式 d = c×[(t_A2-t_A1)-T_proc]/2，
    δ 完全被差分消去，不依赖跨板同步精度
    - §4.8.3 时序编排：明确 t_B1/t_B2 同用 esp_timer_get_time()（同一时钟域，
    T_proc 自洽）；GPIO 触发线仅作采集开窗，不参与 T_proc 计算
    - §4.8.4 精度预算表：量化粒度 7.15mm，T_proc 误差贡献 0.17mm 可忽略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
2026-05-03 docs(development): 新增演示词汇清单与当前物料开发计划
    - 新增 §9 演示词汇清单：5 句单手 + 5 句双手协同，全部不依赖声学测距
    - 新增 §10 当前物料盘点（第二块 ESP32-S3 + 弯曲传感器已到货）
    - 新增 §10.2 四阶段开发计划（P1 Slave 固件、P2 弯曲传感器接入、P3 模型训练、P4 声学测距暂缓）
    - 新增 §10.3 近期里程碑验收标准
    - 文档版本升至 MVP-v1.2
2026-05-03 docs: 修正弯曲传感器1路规格引发的假设内容
    弯曲传感器到货确认为单路模块（含信号调理板），非原假设的5路，
    修正两份文档中所有依赖5路假设的描述：
    DEVELOPMENT.md:
    - §7.4：新增单路模块规格说明（自带分压板、无需外接电阻）、
    修正接线步骤为仅接拇指、参考 ADC 读数范围（伸直≈1200/弯曲≈2800）
    - §9 演示词汇：修正单手5句的识别特征（传感器只能感知拇指弯曲，
    '明白了'改为'竖拇指'手势以规避食指无法感知的问题）；
    修正双手5句识别特征（Slave无传感器，明确依赖IMU+拇指辅助）
    - §10.1：物料盘点确认弯曲传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
2026-05-31 feat: 实现了用户登录接口
